Mikowski02/Nanoindenter_B.Sc._Engineering_Thesis/full.png

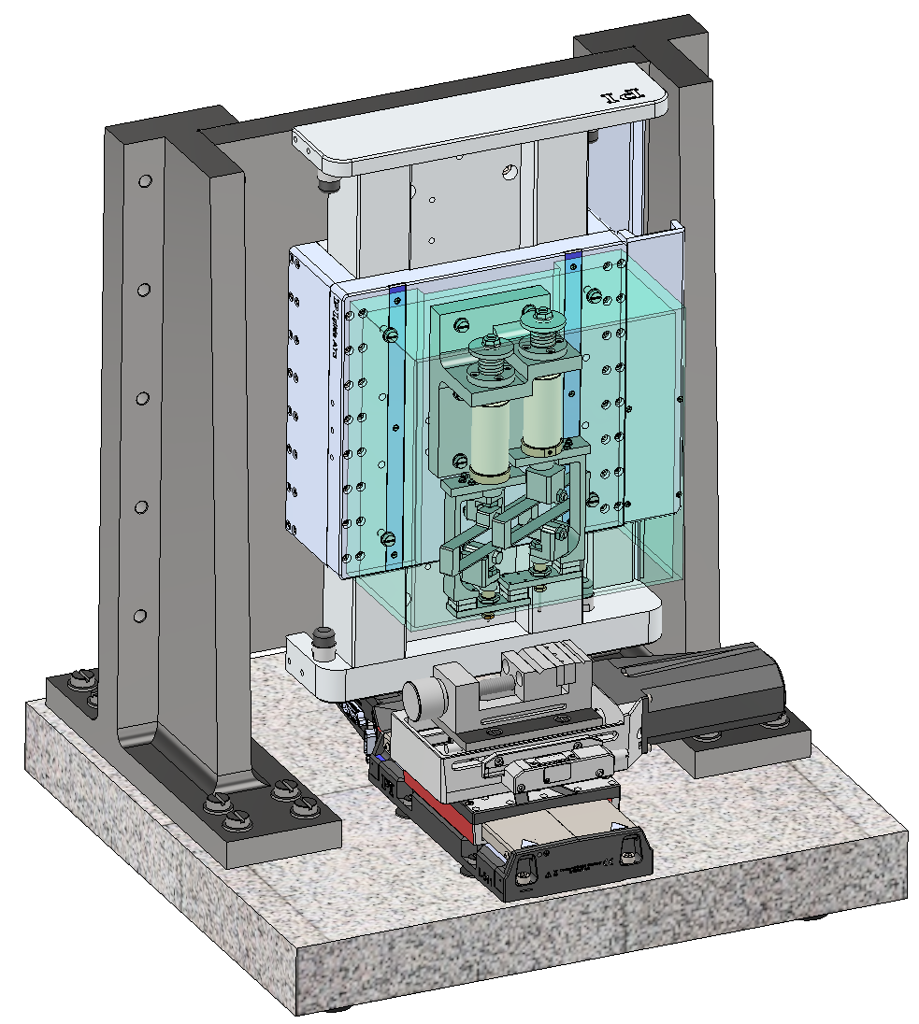
full.png
