Mikowski02/Nanoindenter_B.Sc._Engineering_Thesis/Katalogi elementow konstrukcji/Stolik XY/Screenshot_1.png

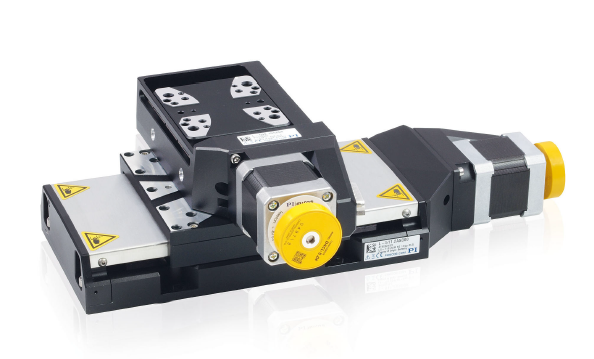
Katalogi elementow konstrukcji/Stolik XY/Screenshot_1.png
