Mikowski02/Nanoindenter_B.Sc._Engineering_Thesis/README.md

Project documentation includes:
  - Autodest Inventor CAD files
  - 2D documentation
  - Selected commercial components with data sheets
  - Results of the FEA analysis
  - Device scheme
