Mikowski02/Nanoindenter_B.Sc._Engineering_Thesis/cad files/02-07-zawieszka_K1.ipt Stress Analysis Report 18.04.2025.html

Image Width (pixels):

# AnalizaFEA-Zawieszka

Analyzed File: | 02-07-zawieszka_K1.ipt
Autodesk Inventor Version: | 2025.2 (Build 292293000, 293)
Creation Date: | 18.04.2025, 12:44
Study Author: | Kacper Mik
Summary:

## Static Analysis:1

General objective and settings:

Design Objective | Single Point
Study Type | Static Analysis
Last Modification Date | 18.04.2025, 12:19
Model State | [Primary]
Detect and Eliminate Rigid Body Modes | No

### iProperties

#### Summary

Author | Kacper Mik

#### Project

Part Number | 02-07-zawieszka_K1
Designer | Kacper Mik
Estimated Cost | 0,00 zł
Creation Date | 15.04.2025

#### Status

Design State | WorkInProgress

#### Physical

Material | Steel ASTM A36
Density | 7,85 g/cm^3
Mass | 0,0580719 kg
Area | 6601,22 mm^2
Volume | 7397,69 mm^3
Center of Gravity | x=0,0000000000227733 mm y=0 mm z=4,99953 mm

Note: Physical values could be different from Physical values used by FEA reported below.

Mesh settings:

Avg. Element Size (fraction of model diameter) | 0,01
Min. Element Size (fraction of avg. size) | 0,01
Grading Factor | 1,5
Max. Turn Angle | 60 deg
Create Curved Mesh Elements | Yes

### Material(s)

Name | Steel ASTM A36
General | Mass Density | 7,85 g/cm^3
| Yield Strength | 248,225 MPa
| Ultimate Tensile Strength | 399,9 MPa
Stress | Young's Modulus | 199,959 GPa
| Poisson's Ratio | 0,3 ul
| Shear Modulus | 76,9073 GPa
Part Name(s) | 02-07-zawieszka_K1.ipt

### Operating conditions

#### Force:1

Load Type | Force
Magnitude | 1,000 N
Vector X | 0,000 N
Vector Y | 1,000 N
Vector Z | 0,000 N

##### Selected Face(s)

#### Fixed Constraint:1

Constraint Type | Fixed Constraint

##### Selected Face(s)

### Results

#### Reaction Force and Moment on Constraints

Constraint Name | Reaction Force | | Reaction Moment
| Magnitude | Component (X,Y,Z) | Magnitude | Component (X,Y,Z)
Fixed Constraint:1 | 1 N | 0 N | 0,000099793 N m | 0,000099793 N m
| | -1 N | | 0 N m
| | 0 N | | 0 N m

#### Result Summary

Name | Minimum | Maximum
Volume | 7397,69 mm^3
Mass | 0,0580719 kg
Von Mises Stress | 0,000325278 MPa | 6,74593 MPa
1st Principal Stress | -0,907167 MPa | 5,30186 MPa
3rd Principal Stress | -7,47351 MPa | 0,117221 MPa
Displacement | 0 mm | 0,0205311 mm
Safety Factor | 15 ul | 15 ul
X Displacement | -0,000233963 mm | 0,000233142 mm
Y Displacement | -0,00000175063 mm | 0,0205311 mm
Equivalent Strain | 0,00000000142282 ul | 0,0000305843 ul

#### Figures

##### Von Mises Stress

##### 1st Principal Stress

##### 3rd Principal Stress

##### Displacement

##### Safety Factor

##### X Displacement

##### Y Displacement

##### Equivalent Strain

C:\Users\kacpe\Documents\STUDIA\INŻYNIERKA\Nanotwardościomierz\Nanotwardosciomierz inventor\02-07-zawieszka_K1.ipt

Image Width (pixels):
