Mikowski02/Nanoindenter_B.Sc._Engineering_Thesis/blokowy schemat.png

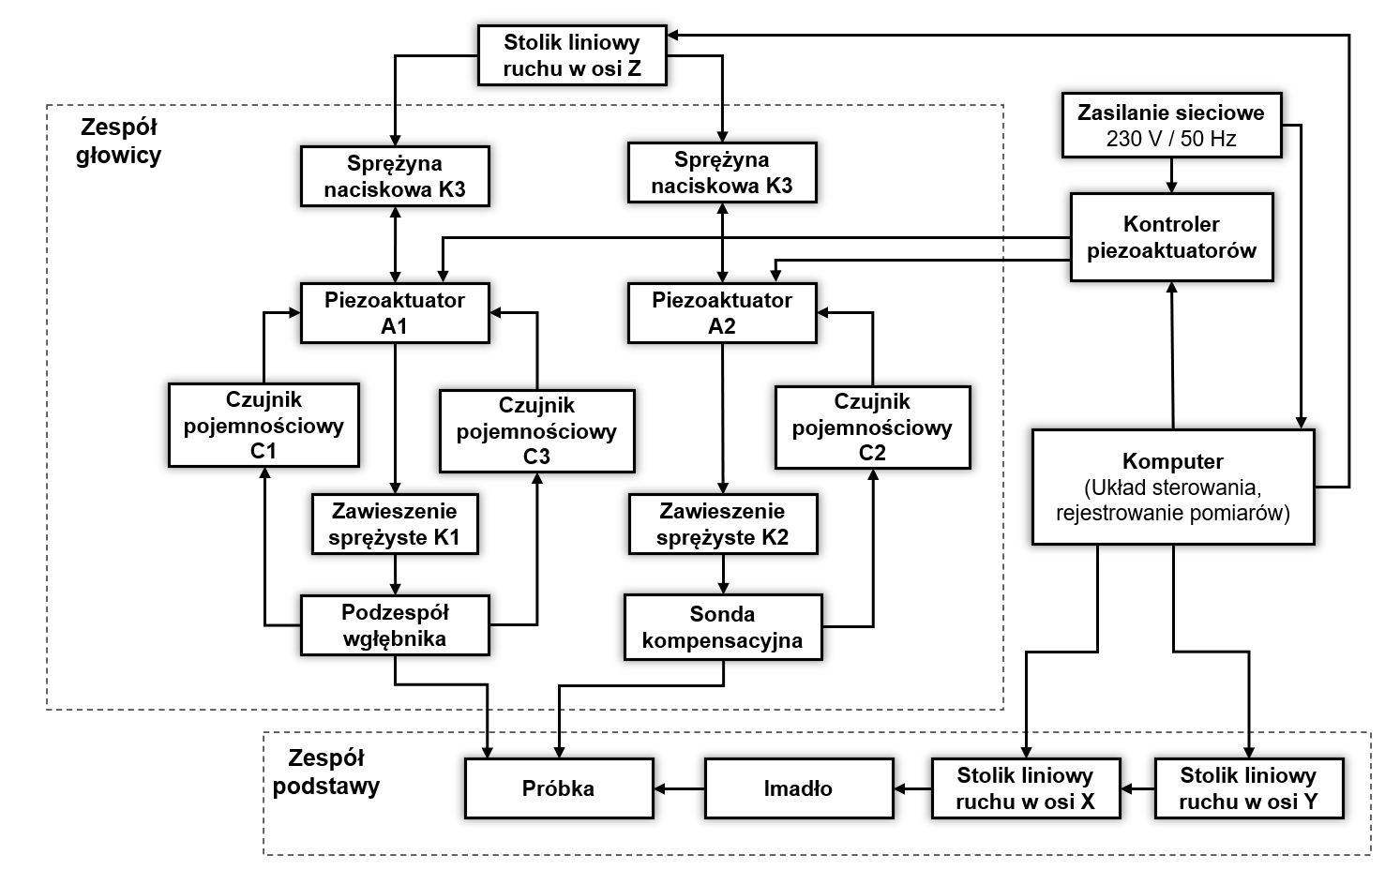
blokowy schemat.png
