Mikowski02/Nanoindenter_B.Sc._Engineering_Thesis/Katalogi elementow konstrukcji/ASTM A36 Steel/Screenshot_5.png

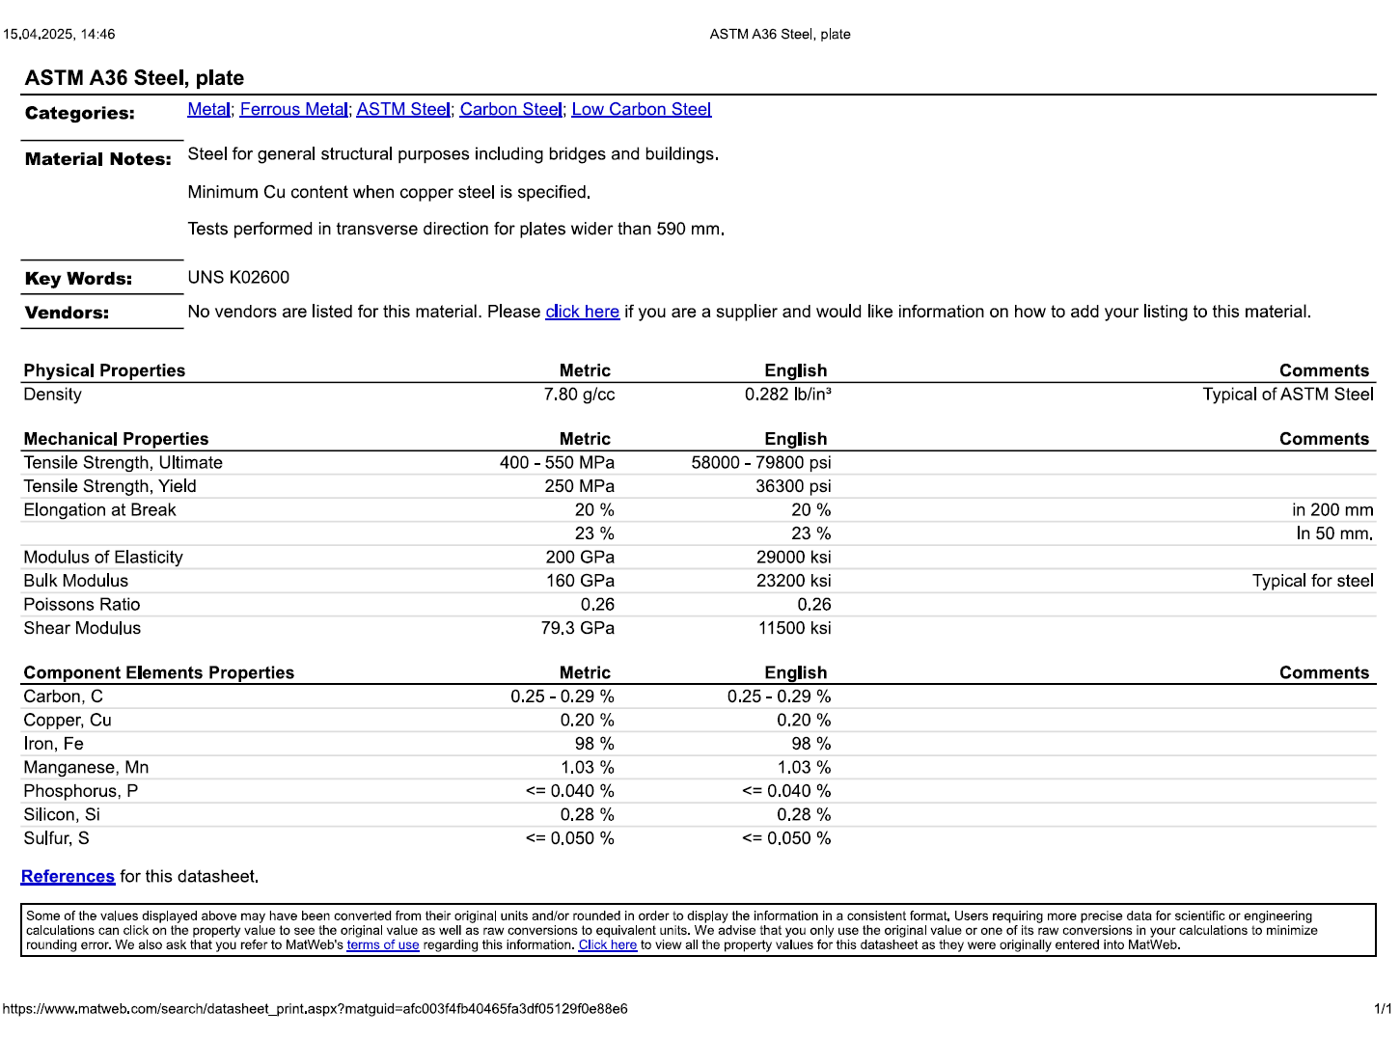
Katalogi elementow konstrukcji/ASTM A36 Steel/Screenshot_5.png
