Mikowski02/Nanoindenter_B.Sc._Engineering_Thesis/Katalogi elementow konstrukcji/Czujniki/22.png

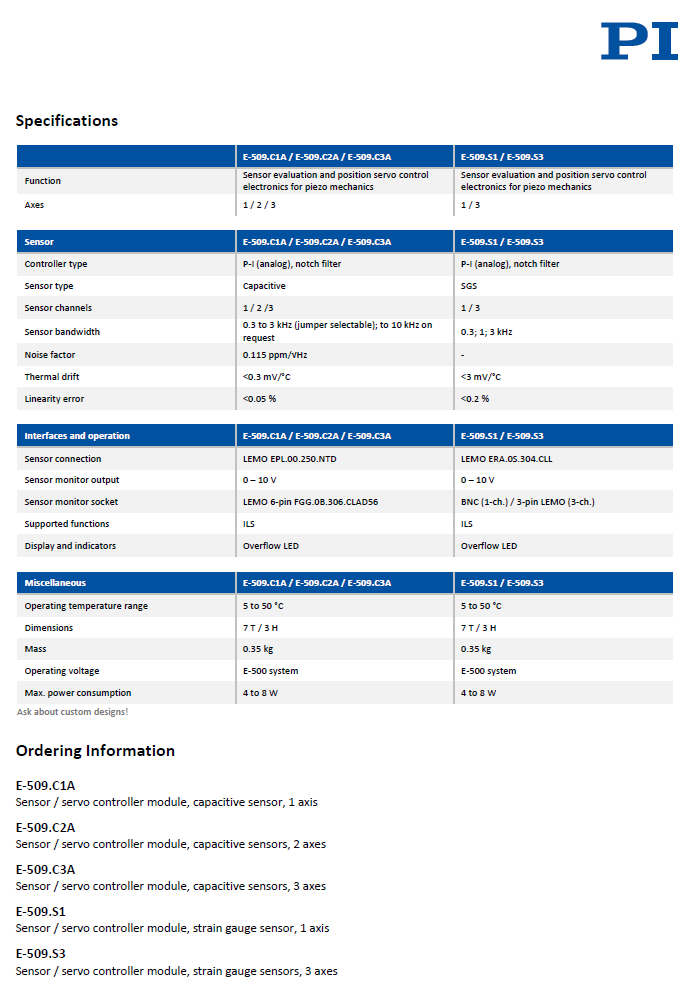
Katalogi elementow konstrukcji/Czujniki/22.png
