Mikowski02/Nanoindenter_B.Sc._Engineering_Thesis/Katalogi elementow konstrukcji/Czujniki/Screenshot_1.png

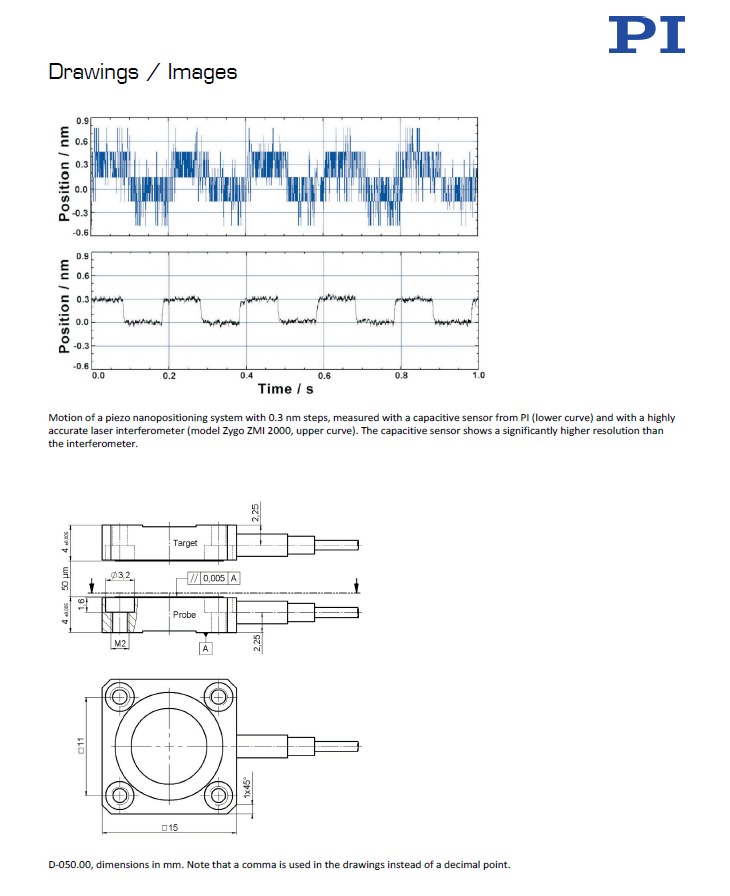
Katalogi elementow konstrukcji/Czujniki/Screenshot_1.png
