Mikowski02/Nanoindenter_B.Sc._Engineering_Thesis/Katalogi elementow konstrukcji/Piezo/Screenshot_1.png

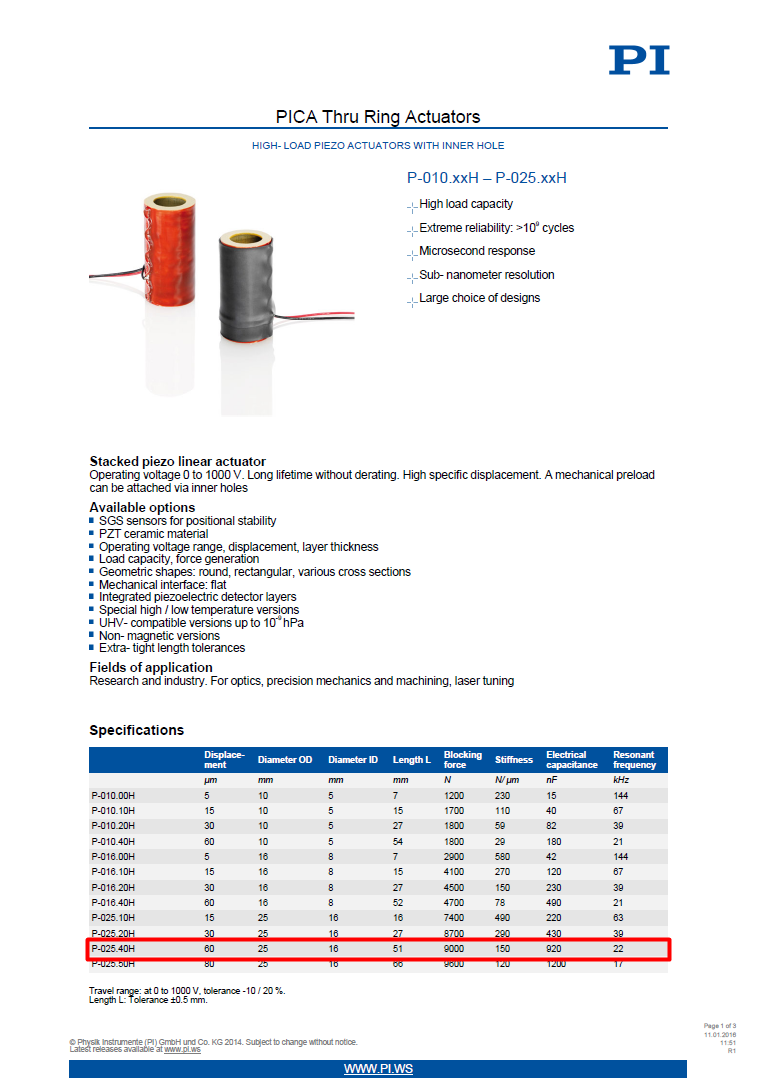
Katalogi elementow konstrukcji/Piezo/Screenshot_1.png
