Mikowski02/Nanoindenter_B.Sc._Engineering_Thesis/Katalogi elementow konstrukcji/Stolik Z/1.png

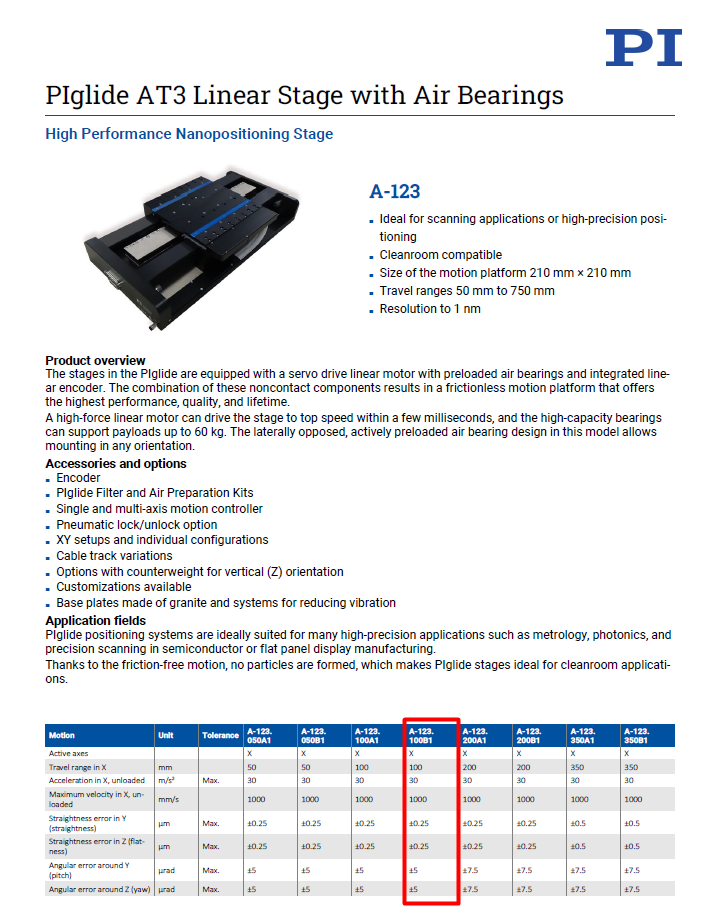
Katalogi elementow konstrukcji/Stolik Z/1.png
