Mikowski02/Nanoindenter_B.Sc._Engineering_Thesis/kinematyczny schemat lepszy.png

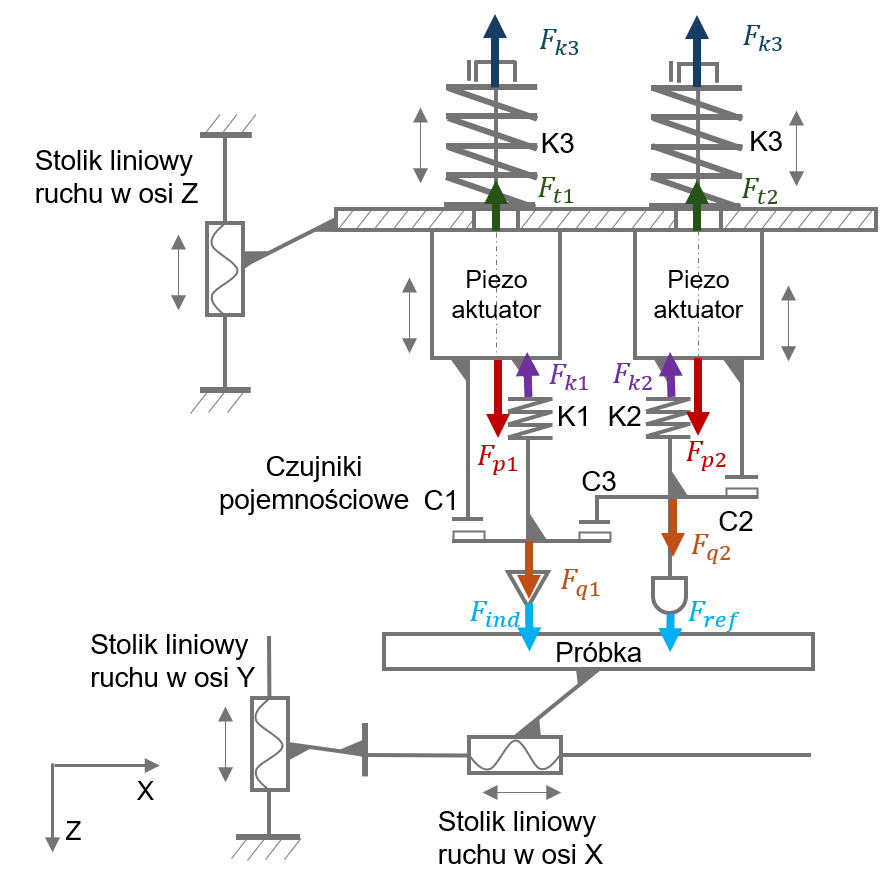
kinematyczny schemat lepszy.png
