Mikowski02/Nanoindenter_B.Sc._Engineering_Thesis/(list of files, cad)

Other CAD files:
RYSUNKI/02-00-zesp_glowicy.dwg
RYSUNKI/00-01-zesp_podstawy.dwg
RYSUNKI/02-08-ind_trzpien_gora.dwg
RYSUNKI/00-00-zlozenie_glowne.dwg
RYSUNKI/KN-02-07.dwg
RYSUNKI/02-01-ind_plytkaC1.dwg
RYSUNKI/02-07-zawieszka_K1-stare.dwg
RYSUNKI/02-13-sprezyna_K3.dwg
RYSUNKI/03-00-zesp_referencji.dwg
RYSUNKI/03-01-glowica_referencyjna.dwg
RYSUNKI/02-08-zawias_K1.dwg
RYSUNKI/01-04-podpora.dwg
RYSUNKI/02-06-tuleja_A0.dwg
RYSUNKI/OldVersions/03-00-zesp_referencji.0008.dwg
RYSUNKI/OldVersions/02-07-zawieszka_K1.0008.dwg
RYSUNKI/OldVersions/02-08-zawias_K1.0008.dwg
RYSUNKI/OldVersions/02-06-tuleja_A0.0014.dwg
RYSUNKI/OldVersions/00-01-zesp_podstawy.0010.dwg
CC/en-US/CNS 4355/CNS 4355 - M 1,4 x 6.ipt
CC/en-US/CNS 4355/CNS 4355 - M 1,4 x 8.ipt
CC/en-US/CNS 9671/CNS 9671 - M1,4 x 4.ipt
CC/en-US/CNS 9671/CNS 9671 - M1,4 x 5.ipt
CC/en-US/CNS 9671/CNS 9671 - M1,4 x 6.ipt
CC/en-US/CNS 9671/CNS 9671 - M1,4 x 8.ipt
CC/en-US/ISO 1207(2)/ISO 1207 - M10 x 60.ipt
CC/en-US/ISO 1207(2)/ISO 1207 - M3 x 8.ipt
CC/en-US/ISO 1207(2)/ISO 1207 - M4 x 10.ipt
CC/en-US/ISO 1207(2)/ISO 1207 - M4 x 12.ipt
CC/en-US/ISO 1207(2)/ISO 1207 - M4 x 14.ipt
CC/en-US/ISO 1207(2)/ISO 1207 - M5 x 10.ipt
CC/en-US/ISO 1207(2)/ISO 1207 - M5 x 16.ipt
CC/en-US/ISO 1207(2)/ISO 1207 - M5 x 20.ipt
CC/en-US/ISO 1207(2)/ISO 1207 - M5 x 25.ipt
CC/en-US/ISO 1207(2)/ISO 1207 - M5 x 30.ipt
CC/en-US/ISO 1207(2)/ISO 1207 - M5 x 35.ipt
CC/en-US/ISO 1207(2)/ISO 1207 - M6 x 10.ipt
CC/en-US/ISO 1207(2)/ISO 1207 - M6 x 12.ipt
CC/en-US/ISO 1207(2)/ISO 1207 - M6 x 14.ipt
CC/en-US/ISO 4014(2)/ISO 4014 - M5 x 25 - ISO.ipt
CC/en-US/ISO 4036(2)/ISO 4036 - M2(2).ipt
CC/en-US/ISO 4036(2)/ISO 4036 - M5(2).ipt
CC/en-US/ISO 4036(2)/ISO 4036 - M6(2).ipt
CC/en-US/ISO 4161/ISO 4161 - M10(1).ipt
CC/en-US/ISO 4161/ISO 4161 - M6(1).ipt
CC/en-US/ISO 4162/ISO 4162 - M5 x 25.ipt
CC/en-US/ISO 4766(2)/ISO 4766 - M2 x 8 - ISO.ipt
CC/en-US/ISO 4766(2)/ISO 4766 - M3 x 8 - ISO.ipt
CC/en-US/ISO 7045 H/ISO 7045 - M2 x 10_ - 4.8 - H - ISO.ipt
CC/en-US/ISO 7045 H/ISO 7045 - M2 x 14_ - 4.8 - H - ISO.ipt
CC/en-US/ISO 7045 H/ISO 7045 - M2 x 8_ - 4.8 - H - ISO.ipt
CC/en-US/ISO 7045 H/ISO 7045 - M3 x 6_ - 4.8 - H - ISO.ipt
CC/en-US/ISO 7045 H/ISO 7045 - M3 x 8_ - 4.8 - H - ISO.ipt
CC/en-US/ISO 7089/ISO 7089 - 10 - 140 HV(1).ipt
CC/en-US/ISO 7089/ISO 7089 - 2 - 140 HV(1).ipt
CC/en-US/ISO 7089/ISO 7089 - 5 - 140 HV(1).ipt
CC/en-US/ISO 7089/ISO 7089 - 6 - 140 HV(1).ipt
CC/en-US/ISO 7092/ISO 7092 - ST 10 - 140 HV.ipt
CC/en-US/ISO 7435(2)/ISO 7435 - M2 x 8ISO.ipt
CC/en-US/ISO 7436(1)/ISO 7436 - M2 x 8ISO.ipt
RYSUNKI/OldVersions/00-00-zlozenie_glowne.0011.idw
RYSUNKI/OldVersions/00-00-zlozenie_glowne.0012.dwg
RYSUNKI/OldVersions/00-01-zesp_podstawy.0005.idw
RYSUNKI/OldVersions/01-04-podpora.0007.dwg
RYSUNKI/OldVersions/02-00-zesp_glowicy.0016.dwg
RYSUNKI/OldVersions/02-07-zawieszka_K1-stare.0002.dwg
RYSUNKI/OldVersions/02-08-ind_trzpien_gora.0004.dwg
RYSUNKI/OldVersions/03-01-glowica_referencyjna.0002.dwg
RYSUNKI/OldVersions/KN-02-07.0001.dwg
cad files/00-01-Podstawa.ipt
cad files/00-01-zesp_podstawy.iam
cad files/01-03-Plyta_stolika_Z.ipt
cad files/01-04-podpora.ipt
cad files/01-04-podpora_MIR.ipt
cad files/01-05-obudowa_pleksa.ipt
cad files/02-00-zesp_glowicy.iam
cad files/02-01-dociskC1.ipt
cad files/02-01-ind_plytkaC1.ipt
cad files/02-01-ind_tulejaC1.ipt
cad files/02-04-ind_trzpien.ipt
cad files/02-05-plyta_A0.ipt
cad files/02-06-tuleja_A0.ipt
cad files/02-08-ind_trzpien_gora.ipt
cad files/02-09-plyta_C1.ipt
cad files/02-11-plyta_dolnaA1.ipt
cad files/02-12-tuleja_dolnaA1.ipt
cad files/02-13-docisk_K3.ipt
cad files/02-14-podkladka_K3.ipt
cad files/02-15-prowadzenie_K3.ipt
cad files/02-15-sprezyna_K3.ipt
cad files/03-00-zesp_referencji.iam
cad files/03-01-glowica_referencyjna.ipt
cad files/D-100.00 Capacitive Sensor.ipt
cad files/Nieudane.ipt
cad files/P-025.40H Piezo Ring Actuators.ipt
cad files/Part1.ipt
cad files/Zawias.ipt
cad files/zesp_czujnikow.iam
cad files/Łożysko liniowe z kołnierzem okrągłym LMF08UU-L.ipt
