Mikowski02/Nanoindenter_B.Sc._Engineering_Thesis/Dokumentacja plaska PDF/KN-00-02-13.pdf

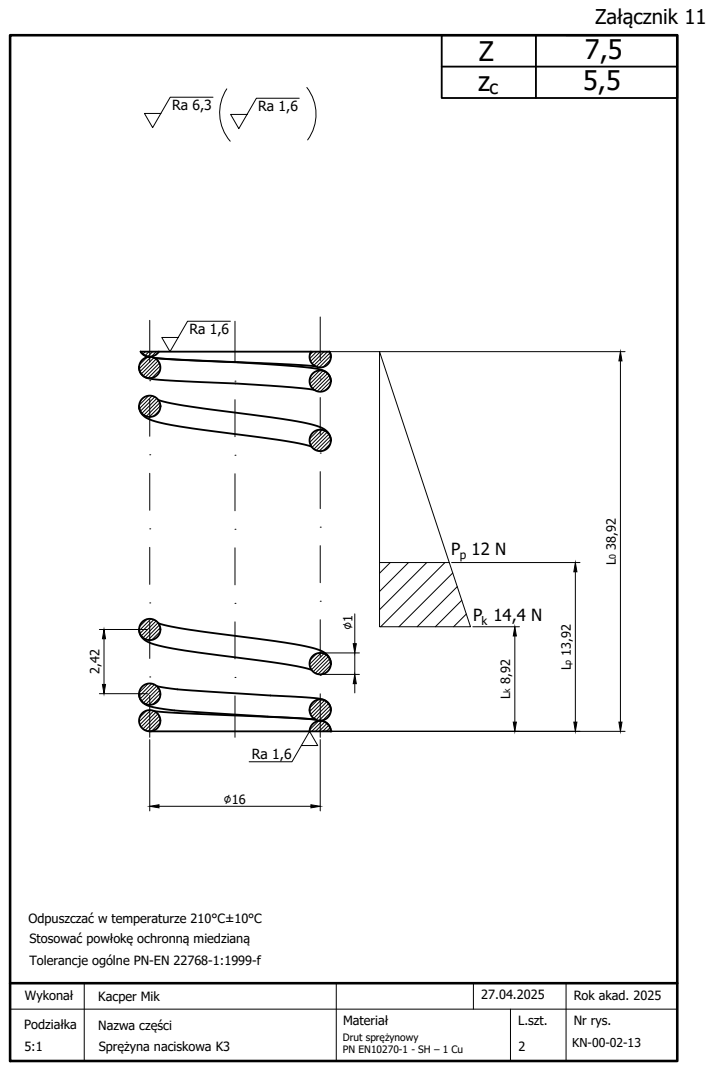
[picture p20: page 1]
Załącznik 11

Z | 7,5
zc | 5,5

Odpuszczać w temperaturze 210°C±10°C
Stosować powłokę ochronną miedzianą
Tolerancje ogólne PN-EN 22768-1:1999-f

Wykonał | Kacper Mik | | 27.04.2025 | Rok akad. 2025

Podziałka 5:1 | Nazwa części Sprężyna naciskowa K3 | Materiał Drut sprężynowy PN EN10270-1 - SH – 1 Cu | L.szt. 2 | Nr rys. KN-00-02-13
