Mikowski02/Nanoindenter_B.Sc._Engineering_Thesis/Dokumentacja plaska PDF/KN-00-00-00.pdf

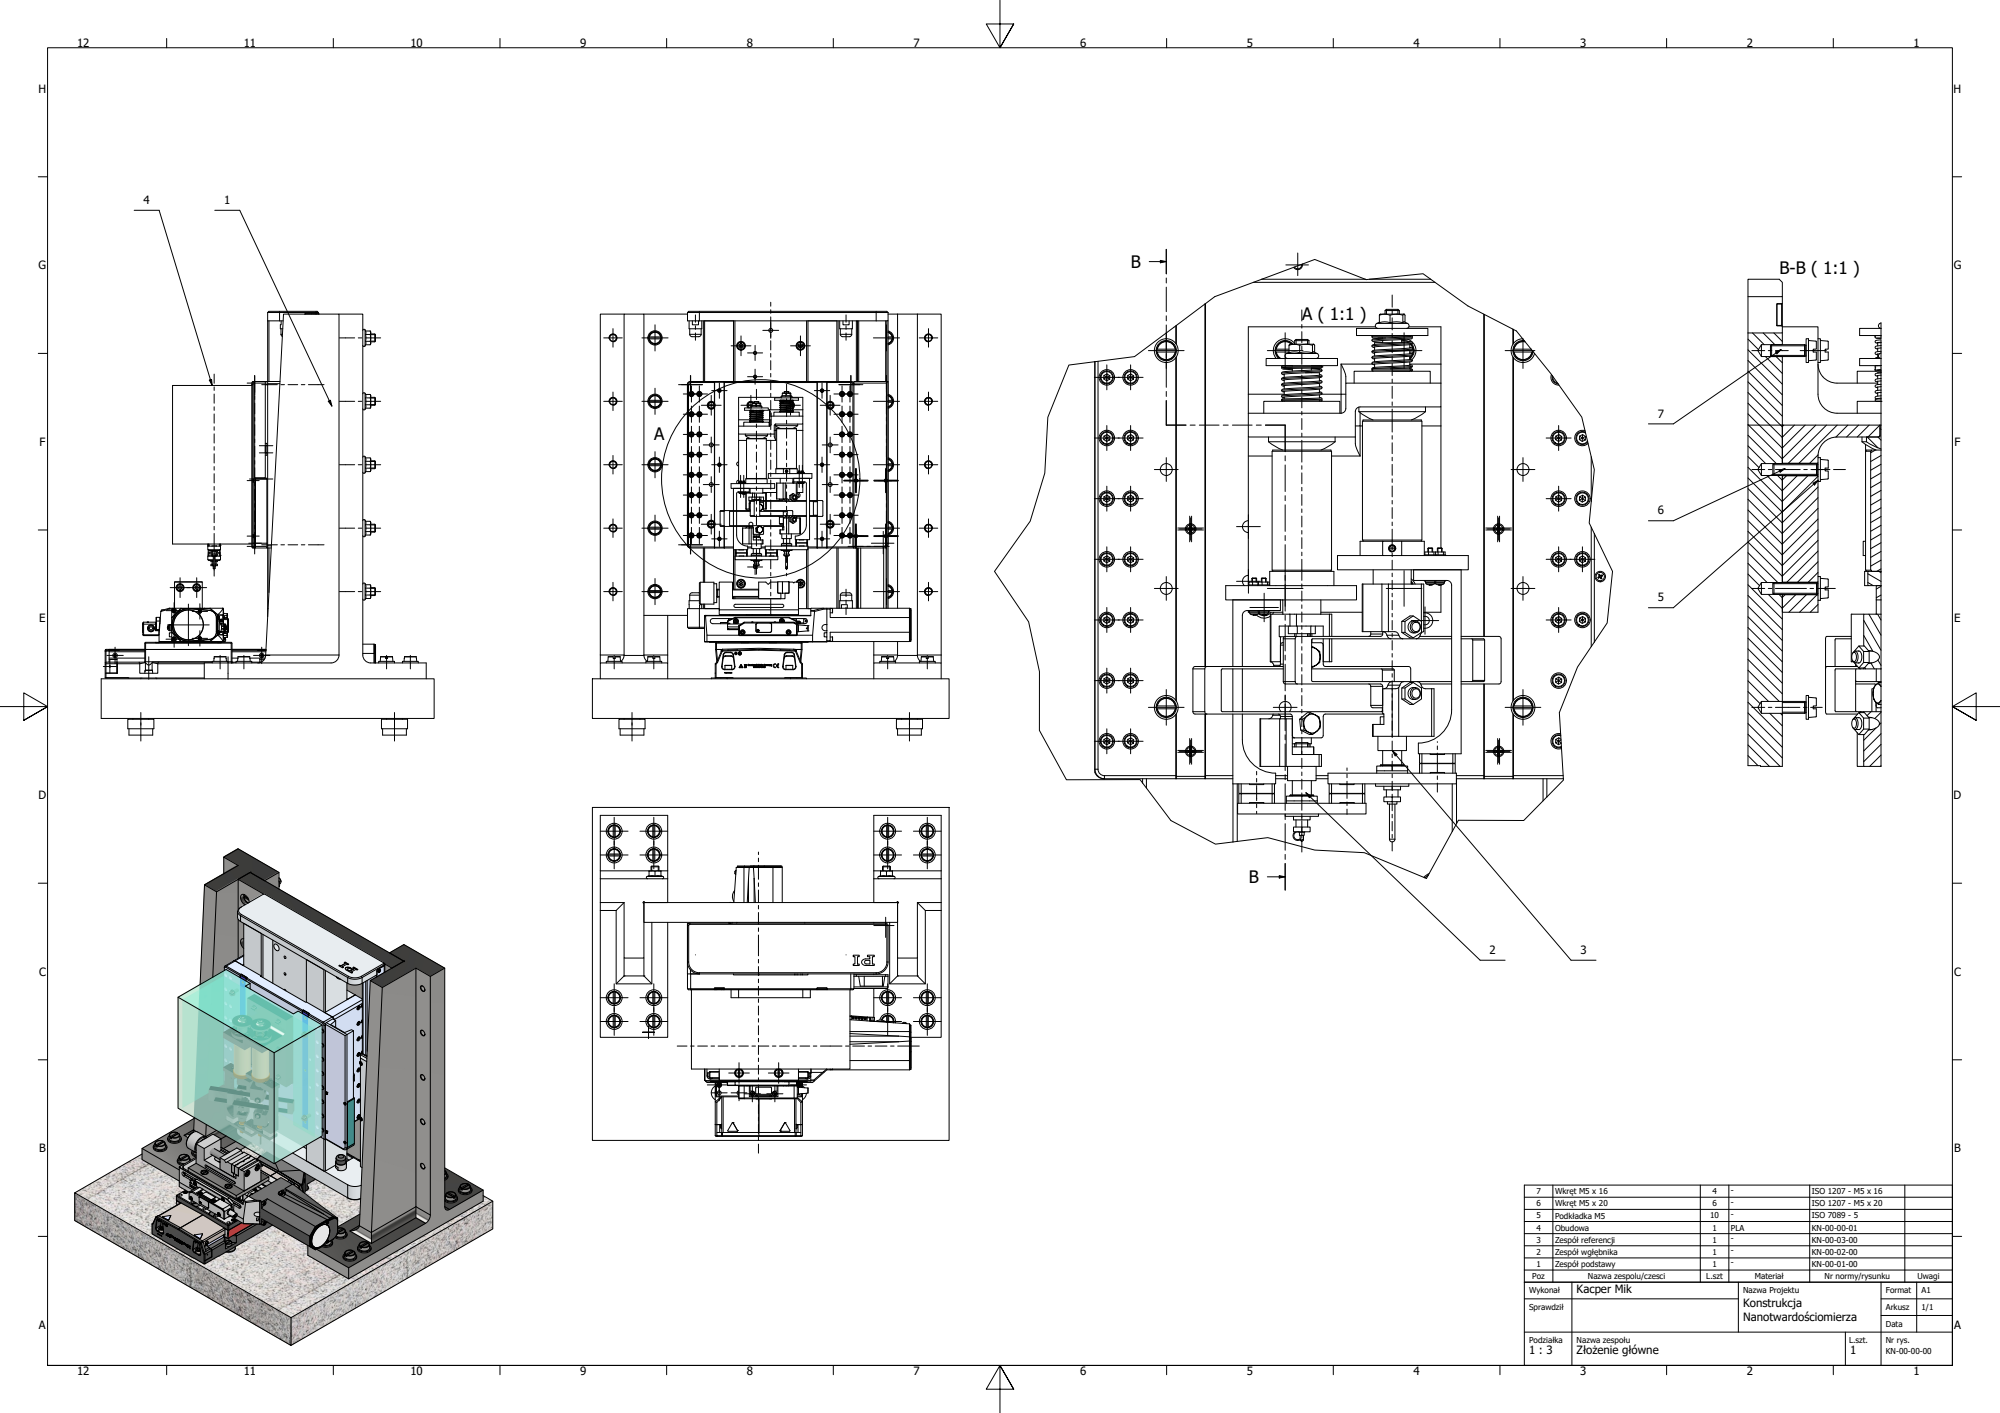
[picture p21: page 1]
Wkręt M5 x 16; ISO 1207 - M5 x 16; Wkręt M5 x 20; ISO 1207 - M5 x 20; Podkładka M5; ISO 7089 - 5; Zespół referencji; Zespół wgłębnika; Zespół podstawy; Poz; Nazwa zespolu/czesci; L.szt; Materiał; Nr normy/rysunku; Uwagi; Podziałka; Nazwa zespołu; L.szt.; Nr rys.; Nazwa Projektu; Złożenie główne; Kacper Mik
