Mikowski02/Nanoindenter_B.Sc._Engineering_Thesis/Dokumentacja plaska PDF/KN-00-01-00.pdf

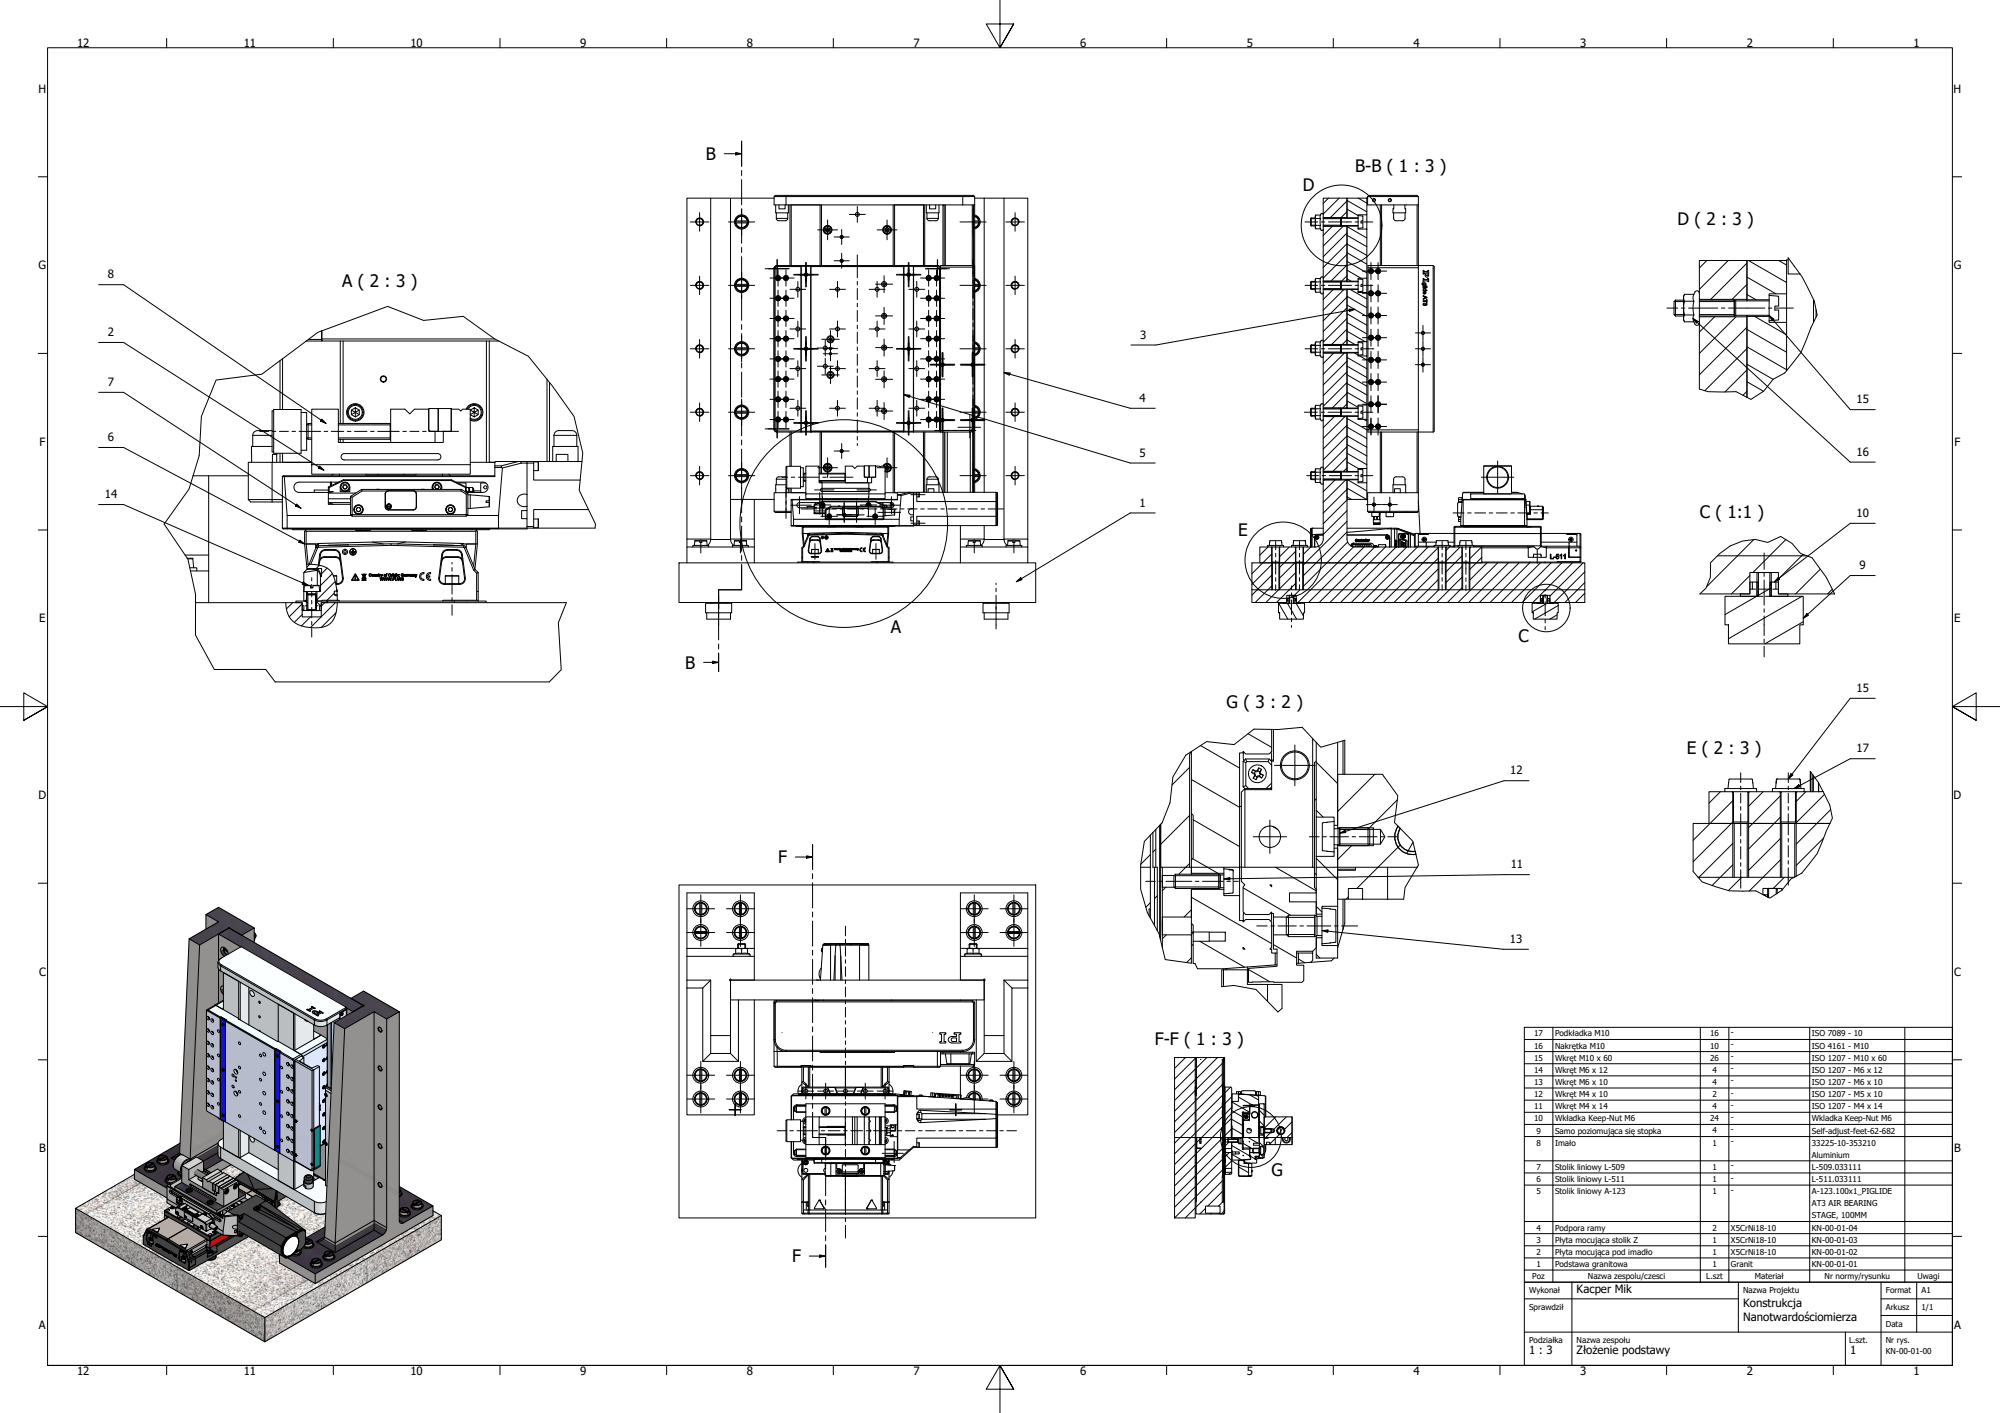
[picture p22: page 1]
