Mikowski02/Nanoindenter_B.Sc._Engineering_Thesis/Dokumentacja plaska PDF/KN-00-01-04.pdf

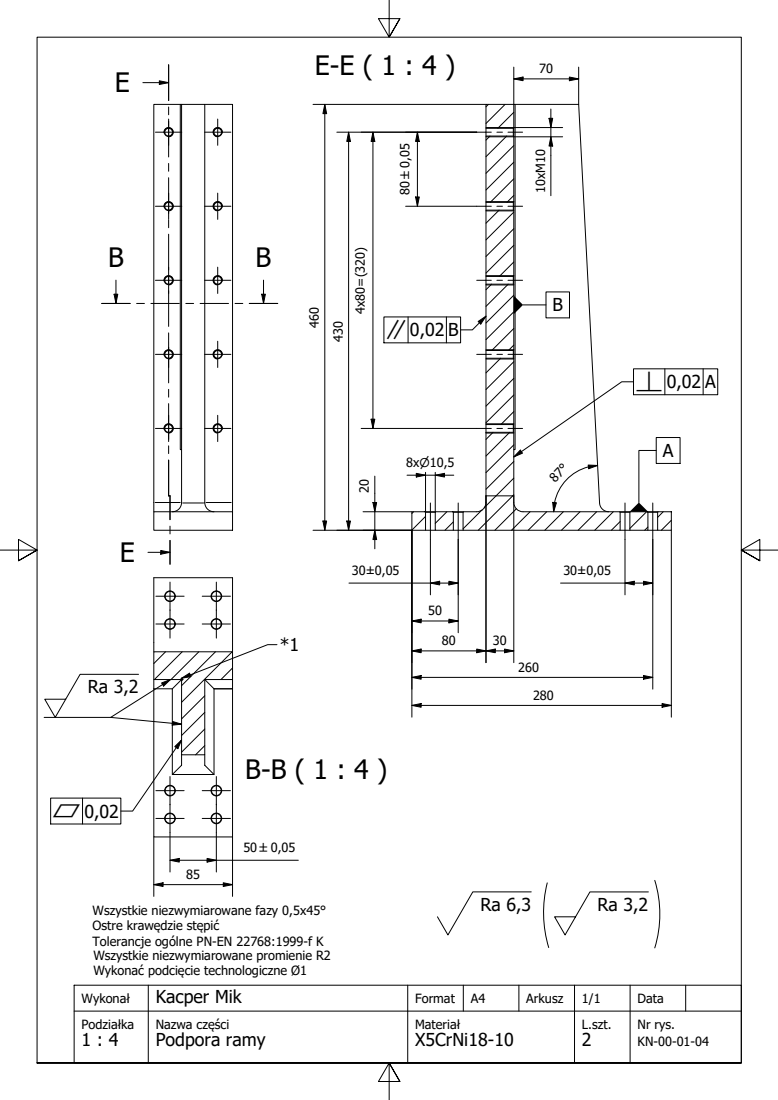
[picture p23: page 1]

Wszystkie niezwymiarowane fazy 0,5x45°
Ostre krawędzie stępić
Tolerancje ogólne PN-EN 22768:1999-f K
Wszystkie niezwymiarowane promienie R2
Wykonać podcięcie technologiczne Ø1

T e m p a e b y A n on D om a ń sk / o ve LS D /Y o gh u Wykonał | Kacper Mik | Format | A4 | Arkusz | 1/1 | Data

Podziałka 1 : 4 | Nazwa części Podpora ramy | Materiał X5CrNi18-10 | | | L.szt. 2 | Nr rys. KN-00-01-04
