Mikowski02/Nanoindenter_B.Sc._Engineering_Thesis/Dokumentacja plaska PDF/KN-00-02-00.pdf

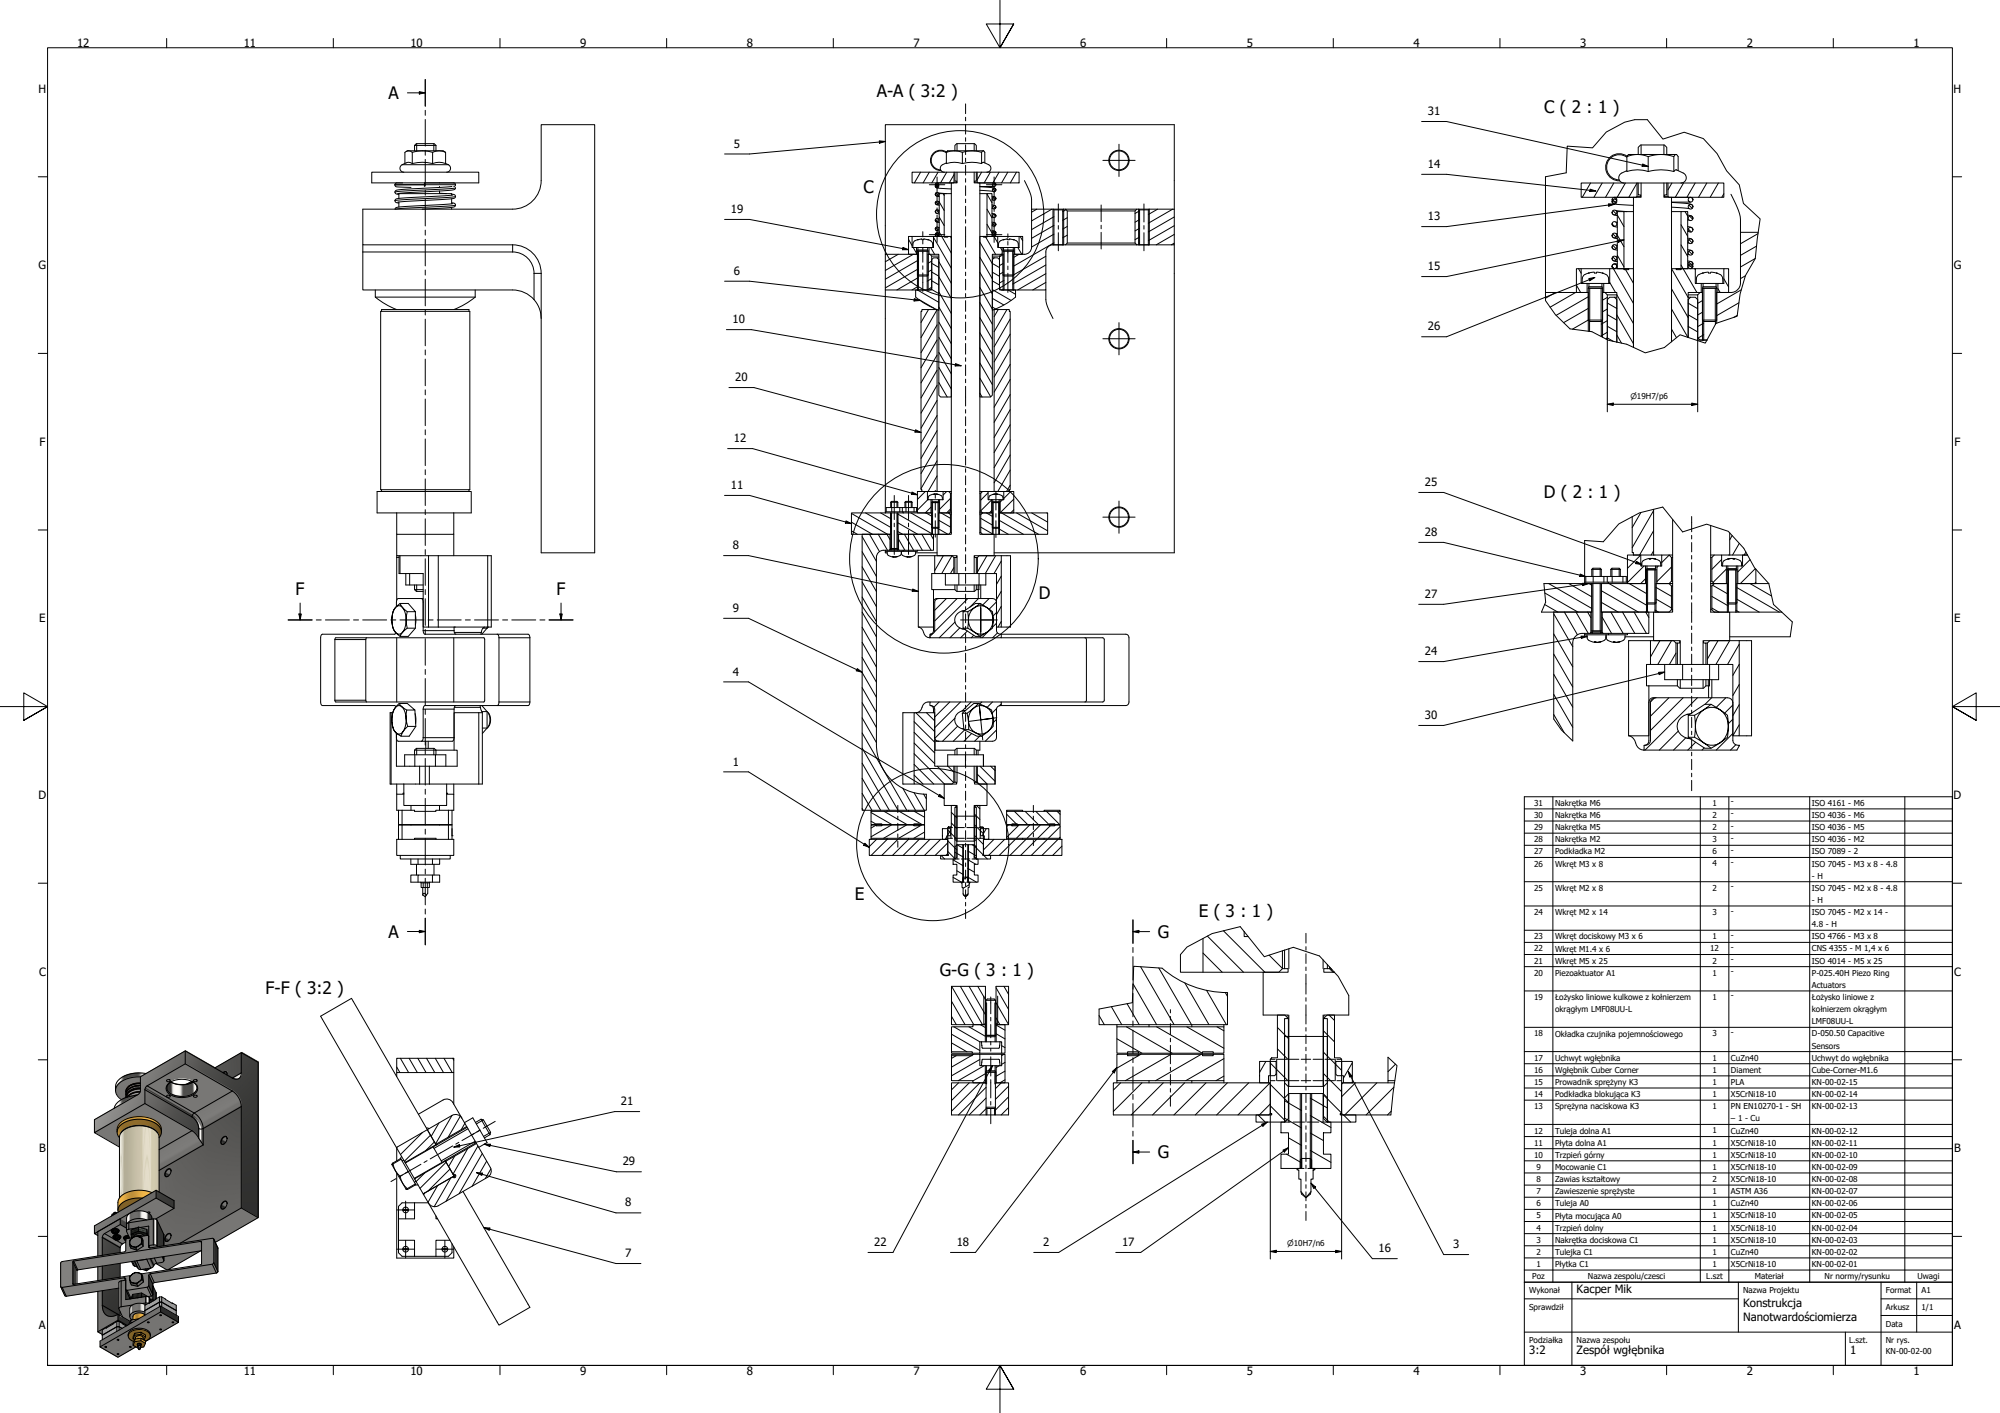
[picture p24: page 1]

3 1 | N a k r ę t k a M 6 | 1 | - | I S O 4 1 6 1 -M 6
3 0 | N a k r ę t k a M 6 | 2 | - | I S O 4 0 3 6 -M 6
2 9 | N a k r ę t k a M 5 | 2 | - | I S O 4 0 3 6 -M 5
2 8 | N a k r ę t k a M 2 | 3 | - | I S O 4 0 3 6 -M 2
2 7 | P o d kł a d k a M 2 | 6 | - | I S O 7 0 8 9 -2
2 6 | W k r ę t M 3 x 8 | 4 | - | I S O 7 0 4 5 -M 3 x 8 -4 . 8 -H

2 3 | W k r ę t d o c i s k o w y M 3 x 6 | 1 | - | I S O 4 7 6 6 -M 3 x 8
2 2 | W k r ę t M 1 . 4 x 6 | 1 2 | - | C N S 4 3 5 5 -M 1 , 4 x 6
2 1 | W k r ę t M 5 x 2 5 | 2 | - | I S O 4 0 1 4 -M 5 x 2 5
2 0 | P i e z o a kt u a t o r A 1 | 1 | - | P -0 2 5 . 4 0 H P i e z o R i n g A c t u a t o r s

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

1 7 | U c h w y t w g ł ę b n i k a | 1 | C u Z n 4 0 | U c h w y t d o w g ł ę b n i k a
1 6 | W g ł ę b n i k C u b e r C o r n e r | 1 | D i a m e n t | C u b e -C o r n e r -M 1 . 6
1 5 | P r o w a d n i k s p r ę ż y n y K 3 | 1 | P L A | K N -0 0 -0 2 -1 5
1 4 | P o d kł a d k a blo k u j ą c a K 3 | 1 | X 5 C r N i 1 8 -1 0 | K N -0 0 -0 2 -1 4
1 3 | S p r ę ż y n a n a c i s k o w a K 3 | 1 | P N E N 1 0 2 7 0 -1 -S H – 1 -C u | K N -0 0 -0 2 -1 3

1 2 | T ulej a d oln a A 1 | 1 | C u Z n 4 0 | K N -0 0 -0 2 -1 2
1 1 | P ł y t a d oln a A 1 | 1 | X 5 C r N i 1 8 -1 0 | K N -0 0 -0 2 -1 1
1 0 | ń ó T r z p i e g r n y | 1 | X 5 C r N i 1 8 -1 0 | K N -0 0 -0 2 -1 0
9 | M o c o w a n i e C 1 | 1 | X 5 C r N i 1 8 -1 0 | K N -0 0 -0 2 -0 9
8 | Z a w i a s k s z t a ł t o w y | 2 | X 5 C r N i 1 8 -1 0 | K N -0 0 -0 2 -0 8
7 | Z a w i e s z e n i e s p r ę ż y s t e | 1 | A S T M A 3 6 | K N -0 0 -0 2 -0 7
6 | T ulej a A 0 | 1 | C u Z n 4 0 | K N -0 0 -0 2 -0 6
5 | P ł y t a m o c u j ą c a A 0 | 1 | X 5 C r N i 1 8 -1 0 | K N -0 0 -0 2 -0 5
4 | ń T r z p i e d oln y | 1 | X 5 C r N i 1 8 -1 0 | K N -0 0 -0 2 -0 4
3 | N a k r ę t k a d o c i s k o w a C 1 | 1 | X 5 C r N i 1 8 -1 0 | K N -0 0 -0 2 -0 3
2 | T ulej k a C 1 | 1 | C u Z n 4 0 | K N -0 0 -0 2 -0 2
1 | P ł y t k a C 1 | 1 | X 5 C r N i 1 8 -1 0 | K N -0 0 -0 2 -0 1
P o z | N a z w a z e s p olu / c z e s c i | L . s z t | M a t e r i a ł | N r n o r m y/ r y s u n k u | U w a g i
W y k o n a ł | K a c p e r M i k | N a z w a P r oj e kt u K o n s t r u k cj a N a n o t w a r d o ś c i o m i e r z a | F o r m a t | A 1
