Mikowski02/Nanoindenter_B.Sc._Engineering_Thesis/Dokumentacja plaska PDF/KN-00-02-06.pdf

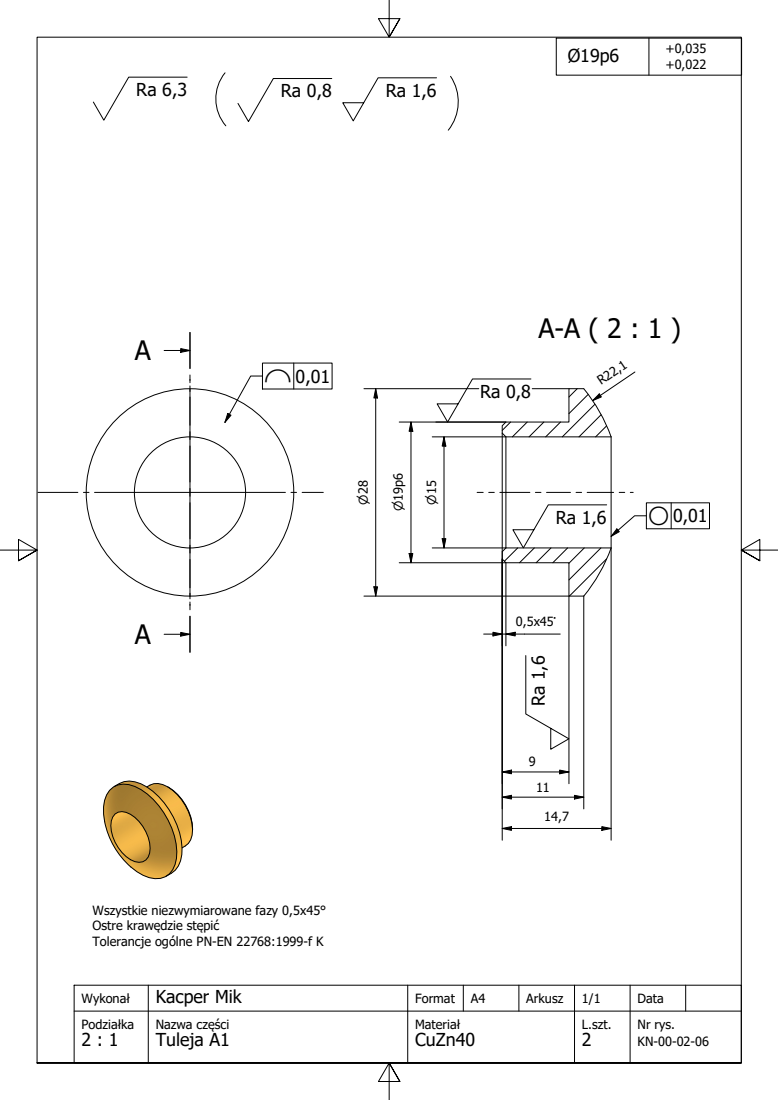
[picture p25: page 1]

Wszystkie niezwymiarowane fazy 0,5x45°
Ostre krawędzie stępić
Tolerancje ogólne PN-EN 22768:1999-f K

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

Podziałka 2 : 1 | Nazwa części Tuleja A1 | Materiał CuZn40 | | | L.szt. 2 | Nr rys. KN-00-02-06
