Mikowski02/Nanoindenter_B.Sc._Engineering_Thesis/Dokumentacja plaska PDF/KN-00-02-08.pdf

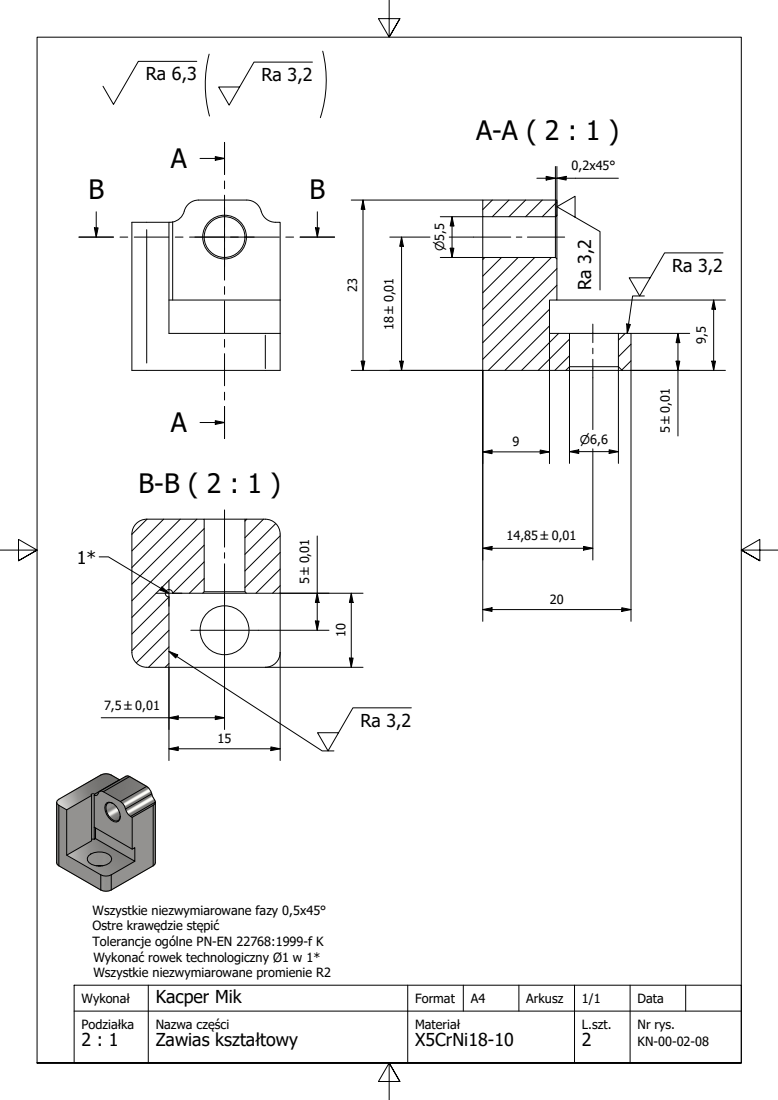
[picture p26: page 1]

Wszystkie niezwymiarowane fazy 0,5x45°
Ostre krawędzie stępić
Tolerancje ogólne PN-EN 22768:1999-f K
Wykonać rowek technologiczny Ø1 w 1*
Wszystkie niezwymiarowane promienie R2

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

Podziałka 2 : 1 | Nazwa części Zawias kształtowy | Materiał X5CrNi18-10 | | | L.szt. 2 | Nr rys. KN-00-02-08
