Mikowski02/Nanoindenter_B.Sc._Engineering_Thesis/Dokumentacja plaska PDF/KN-00-03-00.pdf

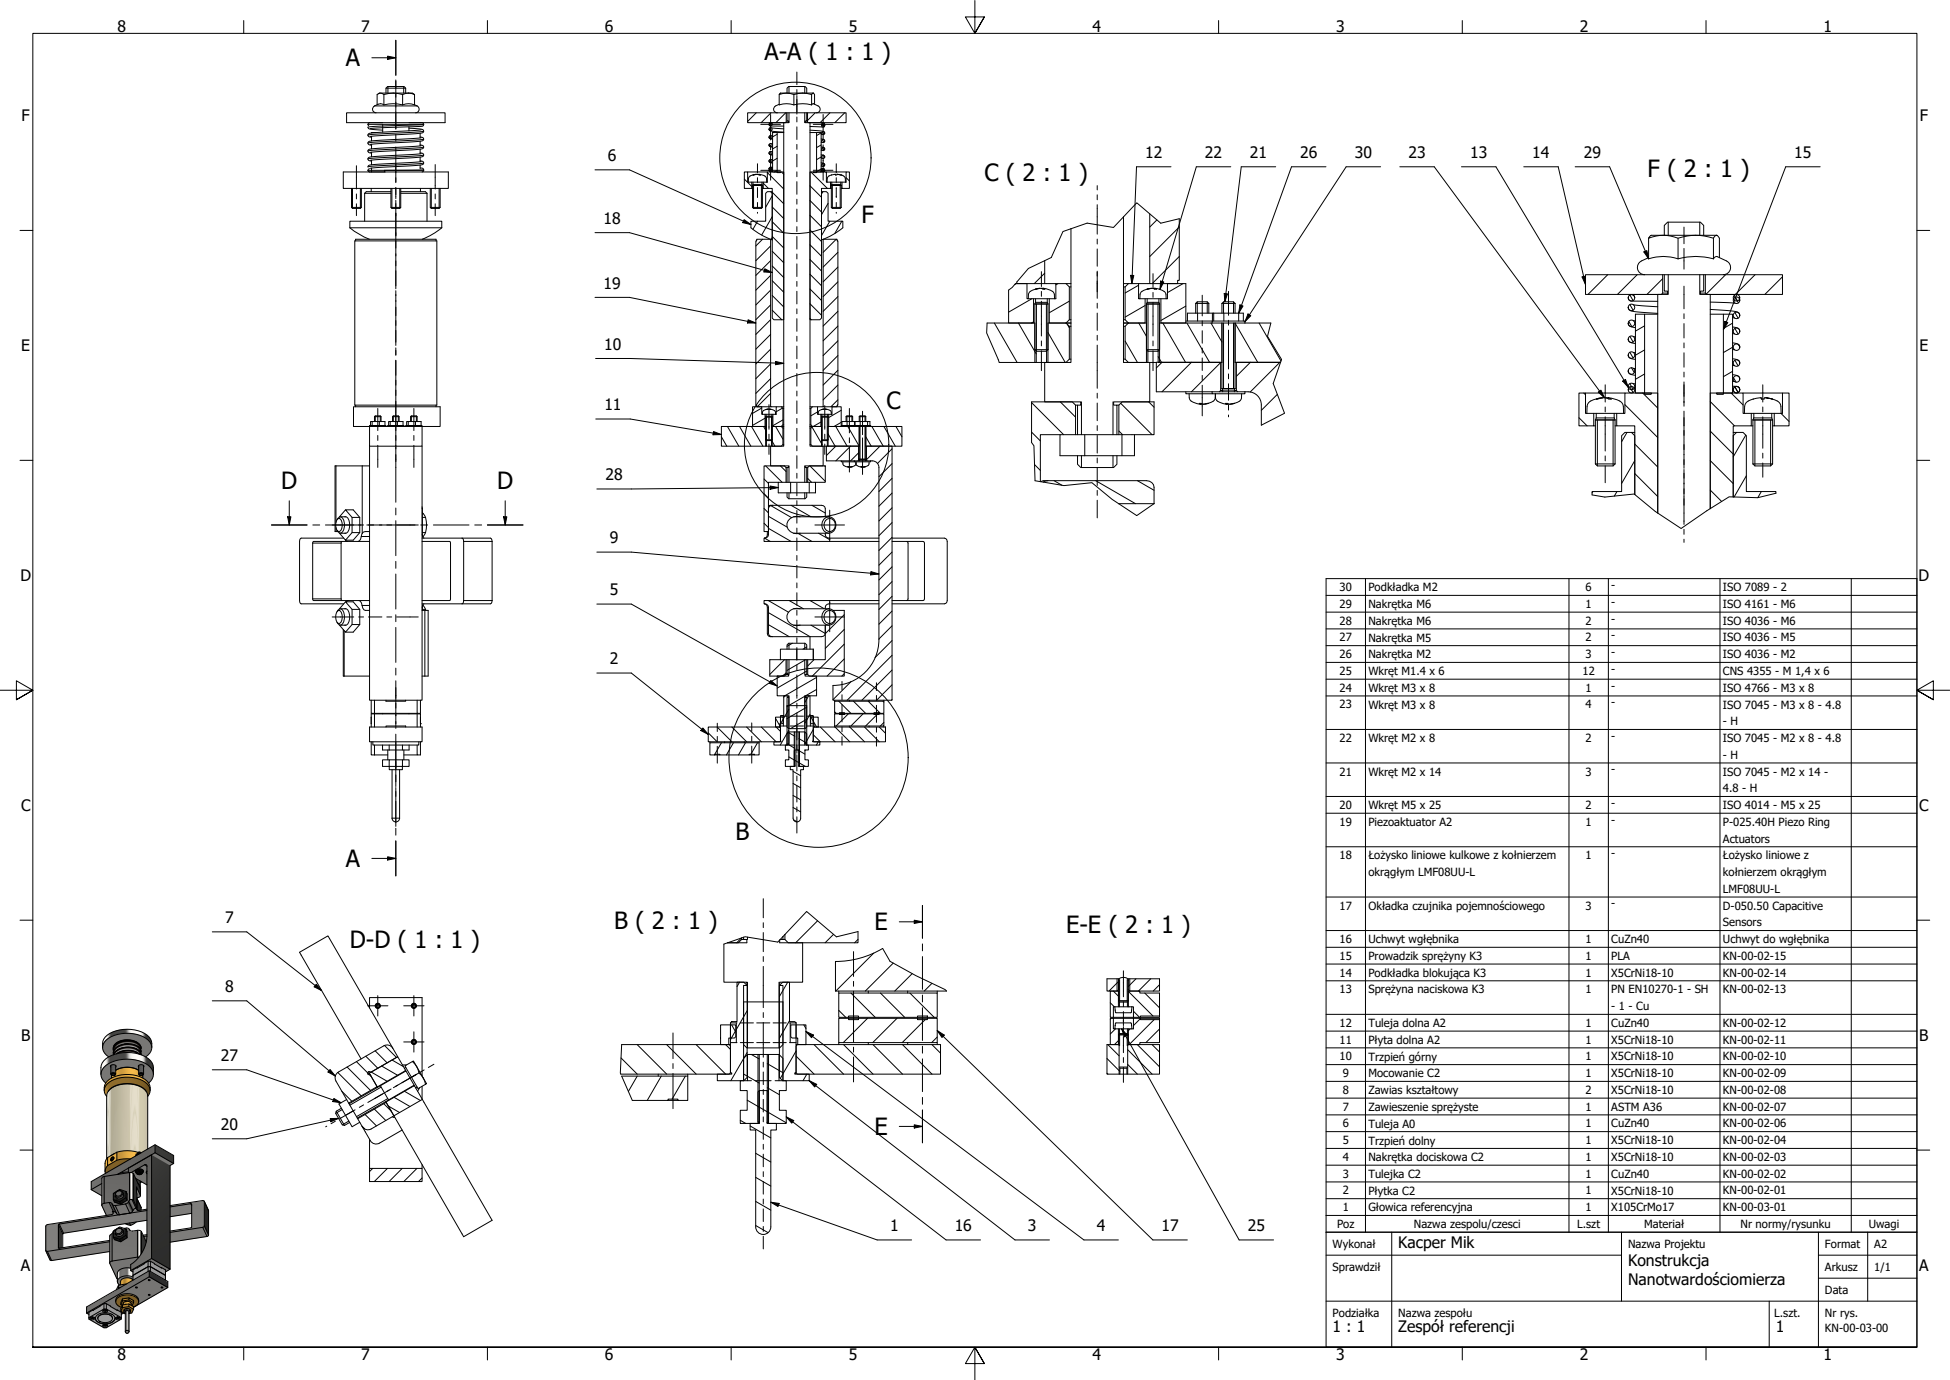
[picture p27: page 1]

3 0 | P o d kł a d k a M 2 | 6 | - | I S O 7 0 8 9 -2
2 9 | N a k r ę t k a M 6 | 1 | - | I S O 4 1 6 1 -M 6
2 8 | N a k r ę t k a M 6 | 2 | - | I S O 4 0 3 6 -M 6
2 7 | N a k r ę t k a M 5 | 2 | - | I S O 4 0 3 6 -M 5
2 6 | N a k r ę t k a M 2 | 3 | - | I S O 4 0 3 6 -M 2
2 5 | W k r ę t M 1 . 4 x 6 | 1 2 | - | C N S 4 3 5 5 -M 1 , 4 x 6
2 4 | W k r ę t M 3 x 8 | 1 | - | I S O 4 7 6 6 -M 3 x 8
2 3 | W k r ę t M 3 x 8 | 4 | - | I S O 7 0 4 5 -M 3 x 8 -4 . 8 -H

2 0 | W k r ę t M 5 x 2 5 | 2 | - | I S O 4 0 1 4 -M 5 x 2 5
1 9 | P i e z o a kt u a t o r A 2 | 1 | - | P -0 2 5 . 4 0 H P i e z o R i n g A c t u a t o r s

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

1 6 | U c h w y t w g ł ę b n i k a | 1 | C u Z n 4 0 | U c h w y t d o w g ł ę b n i k a
1 5 | P r o w a d z i k s p r ę ż y n y K 3 | 1 | P L A | K N -0 0 -0 2 -1 5
1 4 | kł P o d a d k a blo k u j ą c a K 3 | 1 | X 5 C r N i 1 8 -1 0 | K N -0 0 -0 2 -1 4
1 3 | S p r ę ż y n a n a c i s k o w a K 3 | 1 | P N E N 1 0 2 7 0 -1 -S H -1 -C u | K N -0 0 -0 2 -1 3

1 2 | T ulej a d oln a A 2 | 1 | C u Z n 4 0 | K N -0 0 -0 2 -1 2
1 1 | P ł y t a d oln a A 2 | 1 | X 5 C r N i 1 8 -1 0 | K N -0 0 -0 2 -1 1
1 0 | T r z p i e ń g ó r n y | 1 | X 5 C r N i 1 8 -1 0 | K N -0 0 -0 2 -1 0
9 | M o c o w a n i e C 2 | 1 | X 5 C r N i 1 8 -1 0 | K N -0 0 -0 2 -0 9
8 | Z a w i a s k s z t a ł t o w y | 2 | X 5 C r N i 1 8 -1 0 | K N -0 0 -0 2 -0 8
7 | Z a w i e s z e n i e s p r ę ż y s t e | 1 | A S T M A 3 6 | K N -0 0 -0 2 -0 7
6 | T ulej a A 0 | 1 | C u Z n 4 0 | K N -0 0 -0 2 -0 6
5 | T r z p i e ń d oln y | 1 | X 5 C r N i 1 8 -1 0 | K N -0 0 -0 2 -0 4
4 | N a k r ę t k a d o c i s k o w a C 2 | 1 | X 5 C r N i 1 8 -1 0 | K N -0 0 -0 2 -0 3
3 | T ulej k a C 2 | 1 | C u Z n 4 0 | K N -0 0 -0 2 -0 2
2 | P ł y t k a C 2 | 1 | X 5 C r N i 1 8 -1 0 | K N -0 0 -0 2 -0 1
1 | G ł o w i c a r e fe r e n c yj n a | 1 | X 1 0 5 C r M o 1 7 | K N -0 0 -0 3 -0 1
P o z | N a z w a z e s p olu / c z e s c i | L . s z t | M a t e r i a ł | N r n o r m y/ r y s u n k u | U w a g i
W y k o n a ł | K a c p e r M i k | N a z w a P r oj e kt u K o n s t r u k cj a N a n o t w a r d o ś c i o m i e r z a | F o r m a t | A 2
